jawal19/Lightweight-Machine-Element/README.md

# Project-B
 Lightweight Machine Element using FEA design
