jawal19/Lightweight-Machine-Element/Concept Design/Initial Design MK11.PNG

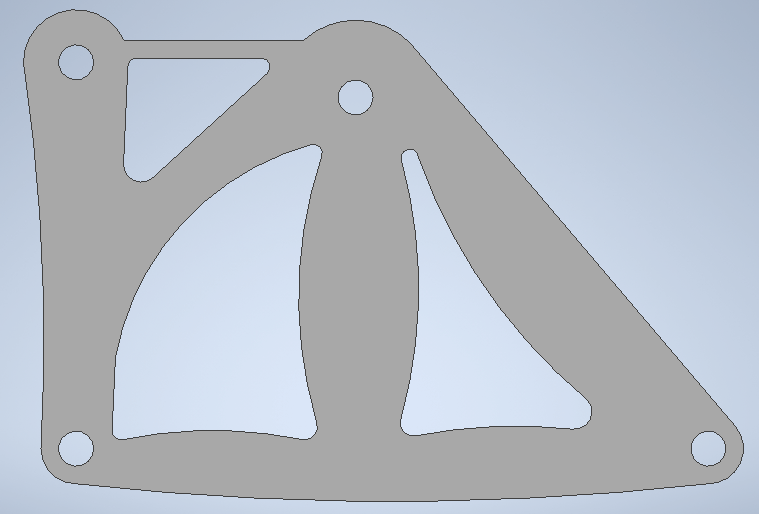
Concept Design/Initial Design MK11.PNG
