jawal19/Lightweight-Machine-Element/Report/Force Disp Calc Image.png

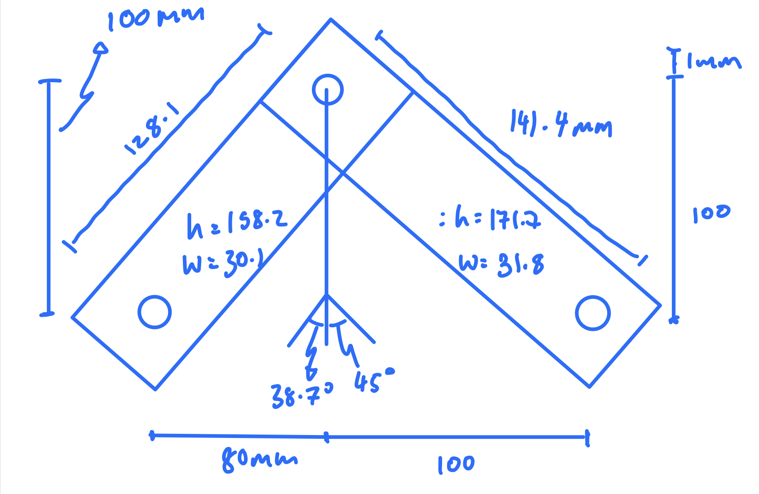
Report/Force Disp Calc Image.png
