jawal19/Lightweight-Machine-Element/Concept Design/Bracket Assembly MK4.stp

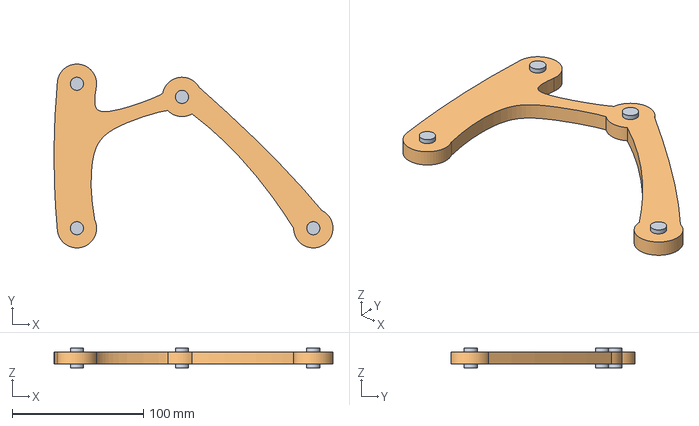
[picture p57: CAD file, 2021-07-16]
Concept Design/Bracket Assembly MK4.stp
212.5 x 140.0 x 15.0 mm
Pin x 4
Bracket Concept MK4
