jawal19/Lightweight-Machine-Element/Concept Design/Bracket Assembly MK1.stp

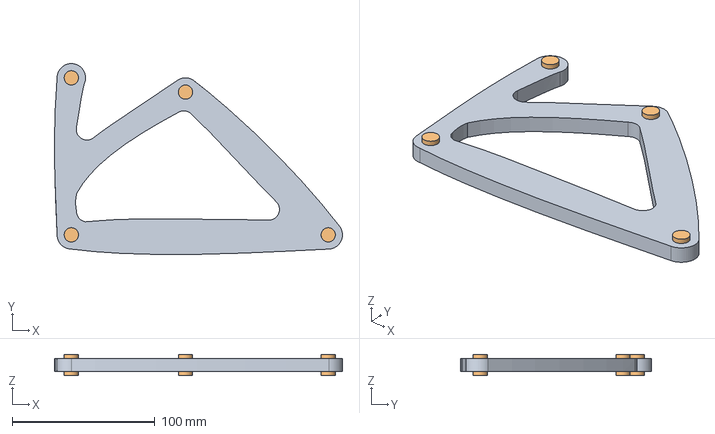
[picture p58: CAD file, 2021-07-16]
Concept Design/Bracket Assembly MK1.stp
201.8 x 133.7 x 15.0 mm
Bracket Concept MK2
Pin x 4
