jawal19/Lightweight-Machine-Element/Final Design Assembly.stp

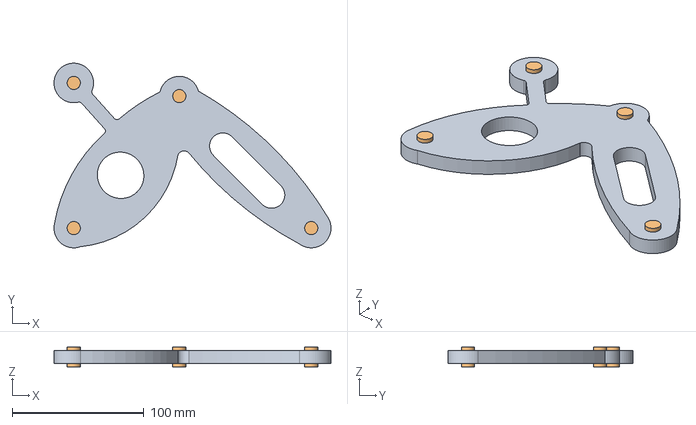
[picture p59: CAD file, 2021-07-16]
Final Design Assembly.stp
210.0 x 140.0 x 15.0 mm
Final Bracket Design
Pins x 4
