jawal19/Lightweight-Machine-Element/Concept Design/Bracket Assembly MK5.stp

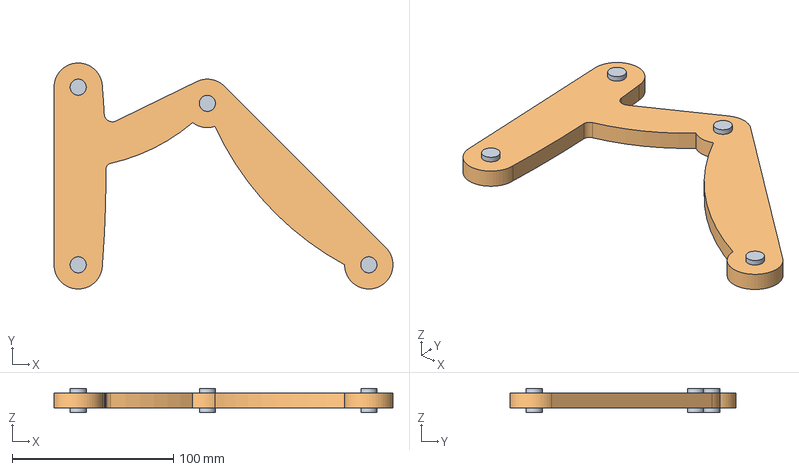
[picture p60: CAD file, 2021-07-16]
Concept Design/Bracket Assembly MK5.stp
210.0 x 140.0 x 15.0 mm
Pin x 4
Bracket Concept MK5
