jawal19/Lightweight-Machine-Element/Concept Design/Bracket Assembly MK10.stp

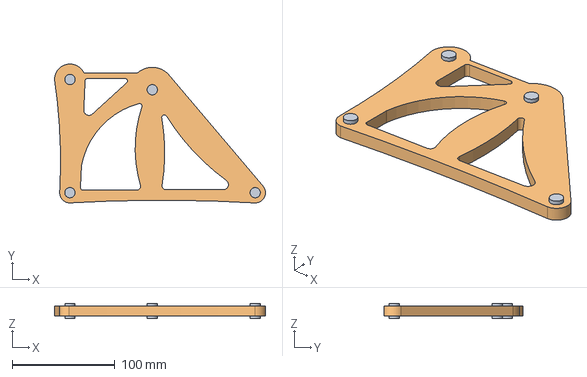
[picture p61: CAD file, 2021-07-16]
Concept Design/Bracket Assembly MK10.stp
205.0 x 135.0 x 15.0 mm
Pin x 4
Bracket Concept MK10
