jawal19/Lightweight-Machine-Element/Concept Design/Bracket Assembly MK3.stp

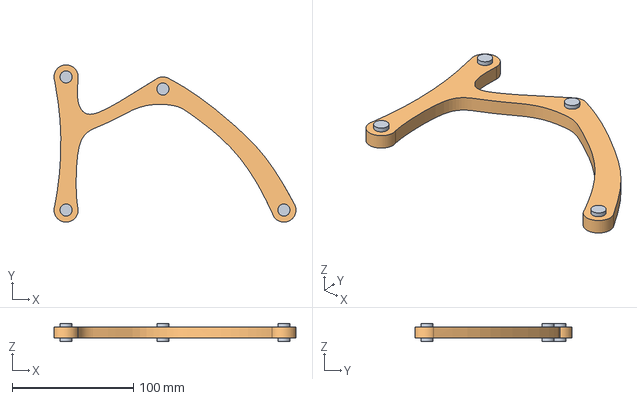
[picture p63: CAD file, 2021-07-16]
Concept Design/Bracket Assembly MK3.stp
200.0 x 130.0 x 15.0 mm
Pin x 4
Bracket Concept MK3
