jawal19/Lightweight-Machine-Element/Concept Design/Bracket Assembly MK29.stp

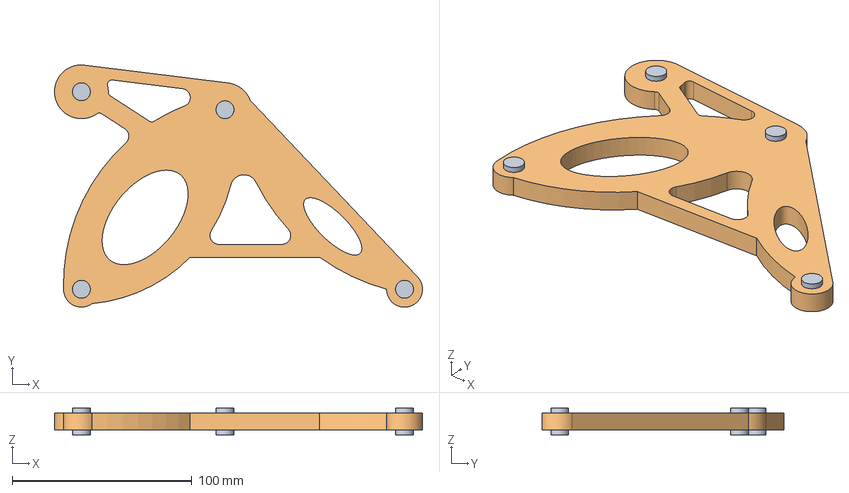
[picture p64: CAD file, 2021-07-16]
Concept Design/Bracket Assembly MK29.stp
205.0 x 135.0 x 15.0 mm
Pins x 4
Bracket Design MK29
