jawal19/Lightweight-Machine-Element/Concept Design/Bracket Assembly MK11.stp

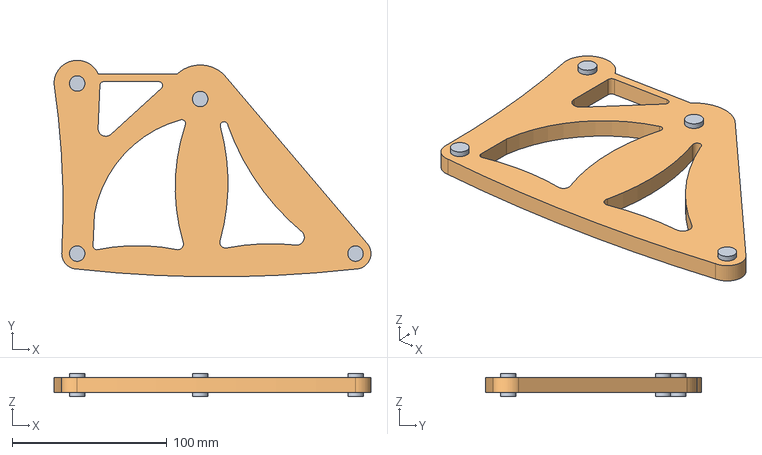
[picture p65: CAD file, 2021-07-16]
Concept Design/Bracket Assembly MK11.stp
205.0 x 139.9 x 15.0 mm
Pin x 4
Bracket Concept MK11
