jawal19/Lightweight-Machine-Element/Concept Design/Bracket Assembly MK6.stp

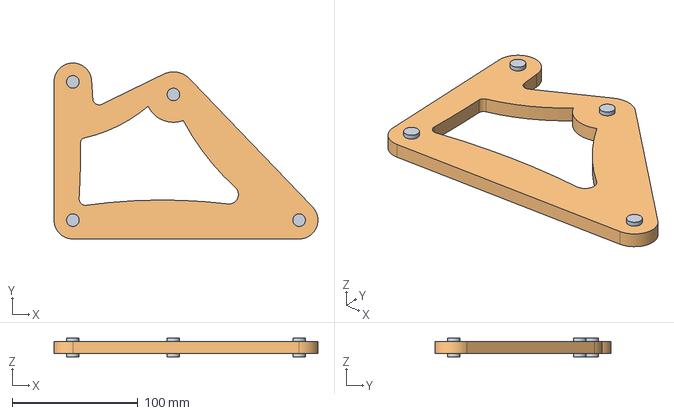
[picture p67: CAD file, 2021-07-16]
Concept Design/Bracket Assembly MK6.stp
210.0 x 140.0 x 15.0 mm
Pin x 4
Bracket Concept MK6
