jawal19/Lightweight-Machine-Element/Calibration Data/2016 Bracket w Pins MK2.stp

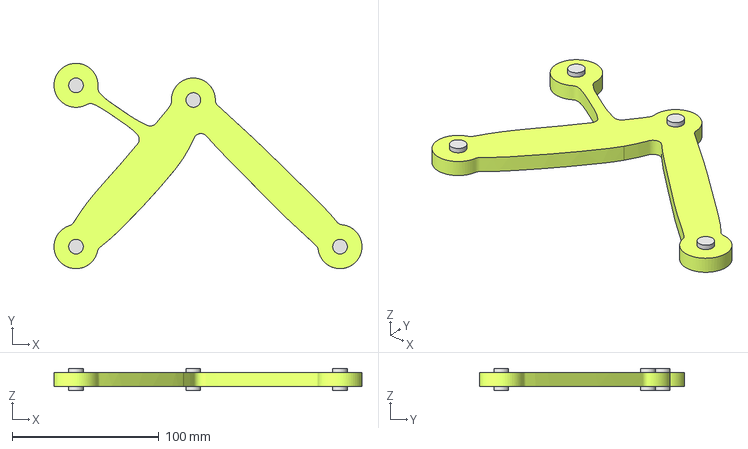
[picture p69: CAD file, 2021-07-16]
Calibration Data/2016 Bracket w Pins MK2.stp
210.0 x 140.0 x 15.0 mm
BRACKET(2)
pins x 4
