jawal19/Lightweight-Machine-Element/Final Bracket Design.stp

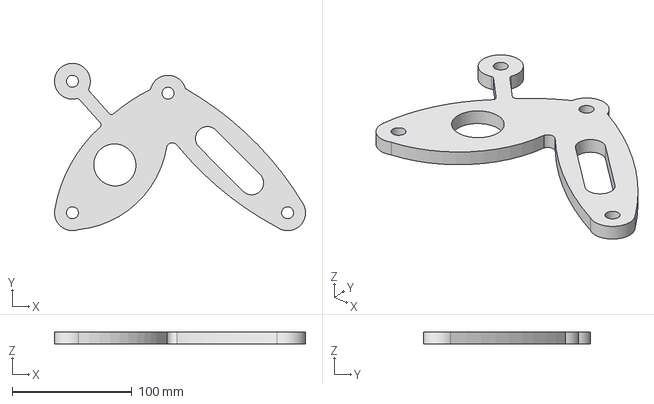
[picture p70: CAD file, 2021-07-16]
Final Bracket Design.stp
210.0 x 140.0 x 9.72 mm
