jawal19/Lightweight-Machine-Element/Calibration Data/MECHENG334 2016 Bracket.step

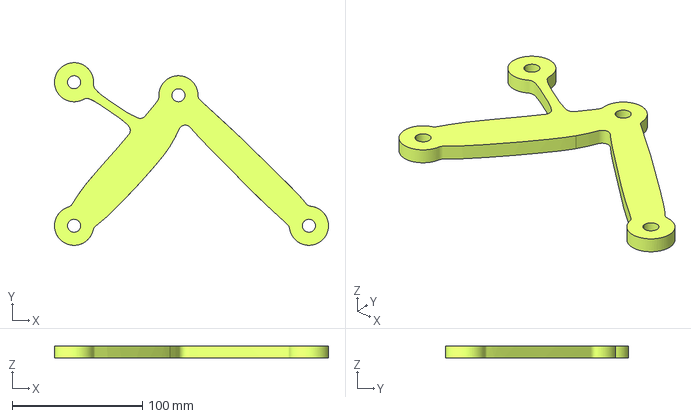
[picture p71: CAD file, 2021-07-16]
Calibration Data/MECHENG334 2016 Bracket.step
210.0 x 140.0 x 9.30 mm
