jawal19/Lightweight-Machine-Element/Concept Design/Bracket Concept MK1.stp

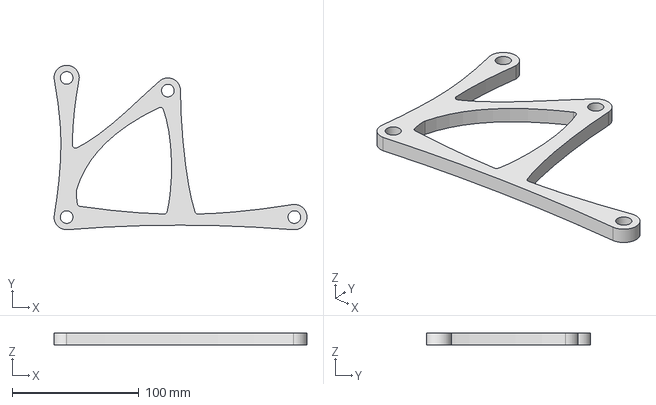
[picture p72: CAD file, 2021-07-16]
Concept Design/Bracket Concept MK1.stp
200.0 x 130.0 x 9.50 mm
