jawal19/Lightweight-Machine-Element/(list of files, cad)

Other CAD files:
Calibration Data/2016 Bracket w Pins.stp
Calibration Data/BRACKET(2).ipt
Calibration Data/MECHENG334 2016 Bracket with pins.iam
Calibration Data/MECHENG334 2016 Bracket.stp
Concept Design/Bracket Assembly MK1.iam
Concept Design/Bracket Assembly MK10.iam
Concept Design/Bracket Assembly MK11.iam
Concept Design/Bracket Assembly MK28.iam
Concept Design/Bracket Assembly MK29.iam
Concept Design/Bracket Assembly MK3.iam
Concept Design/Bracket Assembly MK4.iam
Concept Design/Bracket Assembly MK5.iam
Concept Design/Bracket Assembly MK6.iam
Concept Design/Bracket Assembly MK7.iam
Concept Design/Bracket Assembly MK8.iam
Concept Design/Bracket Assembly MK9.iam
Concept Design/Bracket Concept MK1.ipt
Concept Design/Bracket Concept MK10.ipt
Concept Design/Bracket Concept MK11.ipt
Concept Design/Bracket Concept MK2.ipt
Concept Design/Bracket Concept MK3.ipt
Concept Design/Bracket Concept MK4.ipt
Concept Design/Bracket Concept MK5.ipt
Concept Design/Bracket Concept MK6.ipt
Concept Design/Bracket Concept MK7.ipt
Concept Design/Bracket Concept MK8.ipt
Concept Design/Bracket Concept MK9.ipt
Concept Design/Bracket Design MK28.ipt
Concept Design/Bracket Design MK29.ipt
Concept Design/OldVersions/Bracket Assembly MK10.0001.iam
Concept Design/OldVersions/Bracket Assembly MK4.0001.iam
Concept Design/OldVersions/Bracket Assembly MK9.0001.iam
Concept Design/OldVersions/Bracket Concept MK10.0001.ipt
Concept Design/OldVersions/Bracket Concept MK2.0001.ipt
Concept Design/OldVersions/Bracket Concept MK7.0001.ipt
Concept Design/Pin.ipt
Concept Design/Pins.ipt
Final Bracket Design.ipt
Final Design Assembly.iam
Mounting Plate Assemly.iam
Template.ipt
Tutorial Packages/Tutorial4_2017/impeller.prt
y3_design_mounting_plate_2018.ipt
